ahkar-kyaw/e_me599_Zephyr/03_electrical/datasheets/Pinout_esp32_nodemcu.png

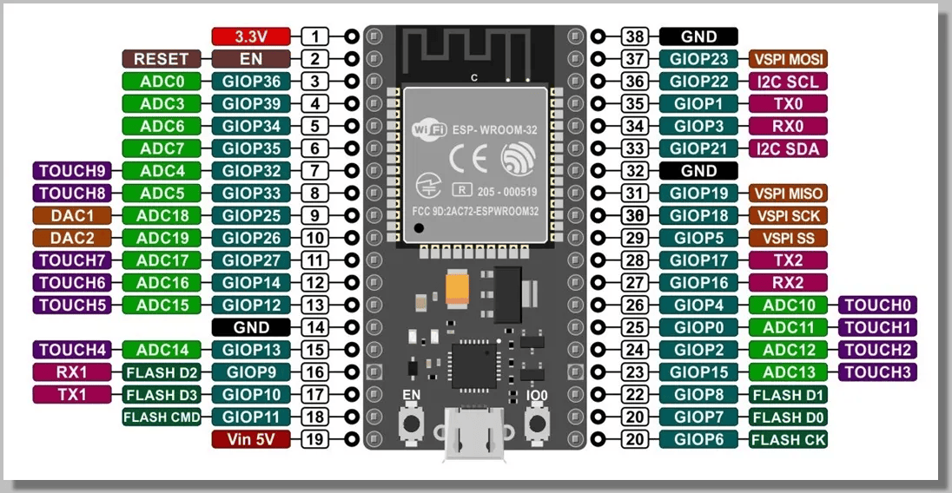
03_electrical/datasheets/Pinout_esp32_nodemcu.png
