ahkar-kyaw/e_me599_Zephyr/README.md

# Collinear mecanum drive self-balancing mobile robot
