ahkar-kyaw/e_me599_Zephyr/99_archive/documentation_actuator_CubeMars_AK40-10_KV170/AK40-10 KV170.STEP

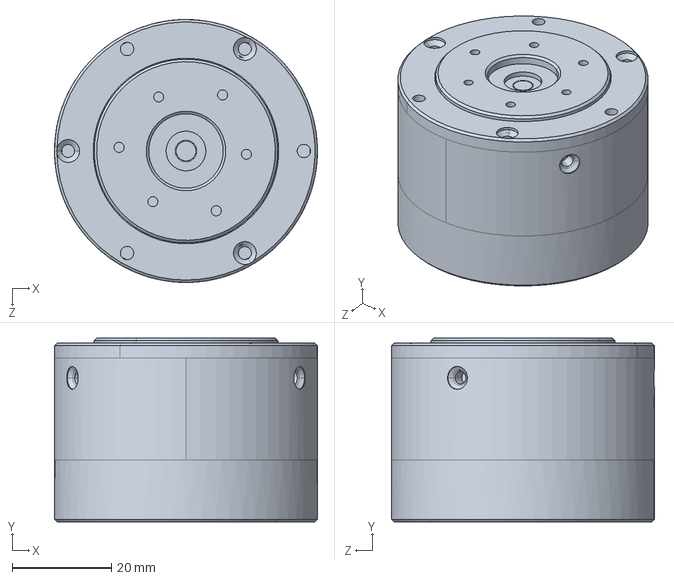
[picture p2: CAD file, 2026-05-18, an earlier design]
99_archive/documentation_actuator_CubeMars_AK40-10_KV170/AK40-10 KV170.STEP
53.0 x 37.0 x 53.0 mm
