ahkar-kyaw/e_me599_Zephyr/03_electrical/esp32_nodemcu/esp32_nodemcu.kicad_sch

## KiCad design 03_electrical/esp32_nodemcu/esp32_nodemcu.kicad_sch (2026-08-22)

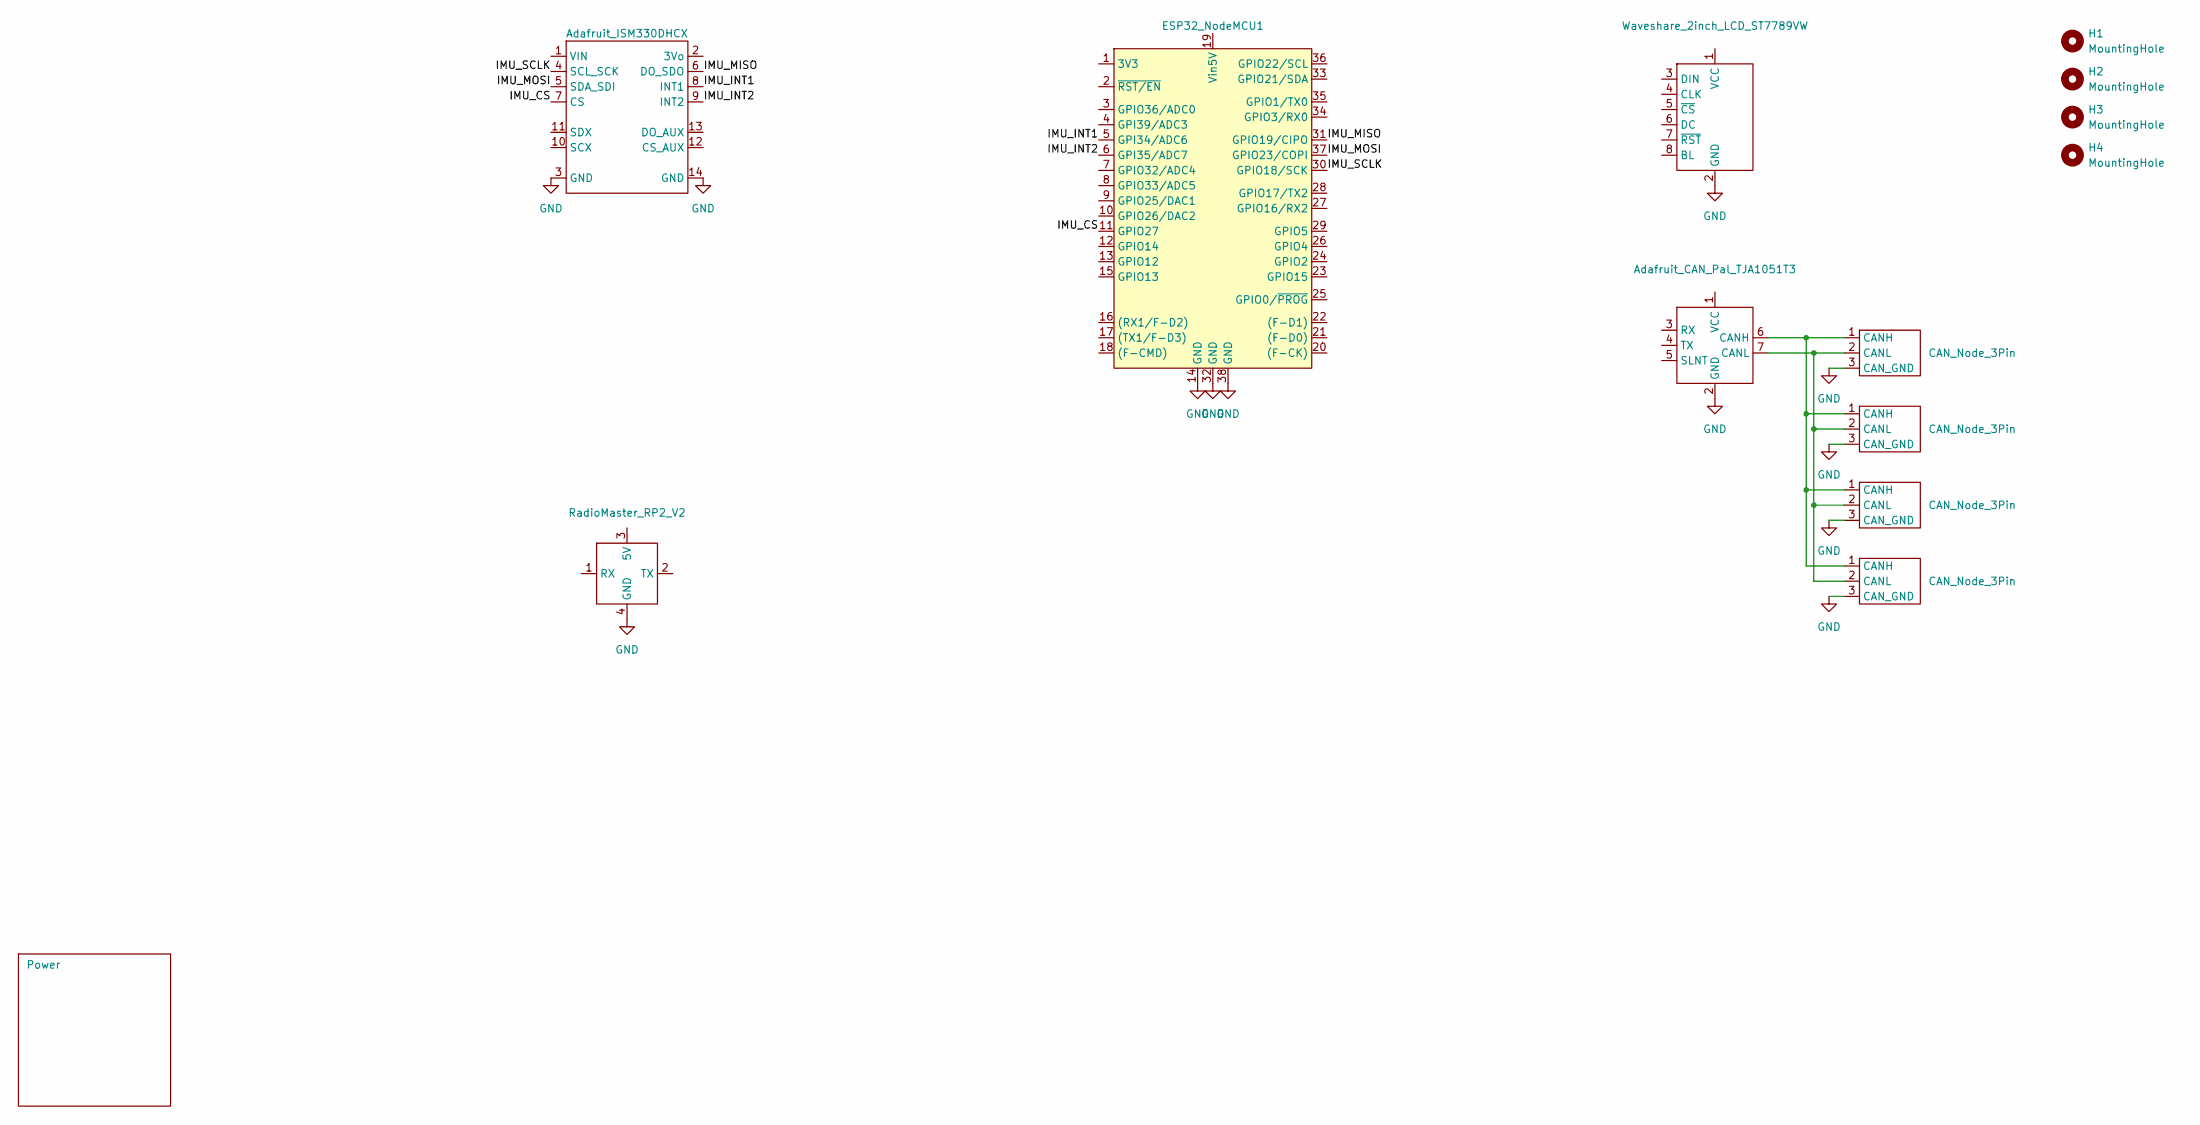
[picture p5: schematic esp32_nodemcu.kicad_sch]

Parts:
A1: Adafruit_ISM330DHCX
A2: Adafruit_CAN_Pal_TJA1051T3
A3: RadioMaster_RP2_V2
DS1: Waveshare_2inch_LCD_ST7789VW
H1, H2, H3, H4: MountingHole
J1, J2, J3, J4: CAN_Node_3Pin
U1: ESP32_NodeMCU1; ESP32_NodeMCU

Connections:
GND: A1.3 (GND), A1.14 (GND), A2.2 (GND), A3.4 (GND), DS1.2 (GND), J1.3 (CAN_GND), J2.3 (CAN_GND), J3.3 (CAN_GND), J4.3 (CAN_GND), U1.14 (GND), U1.32 (GND), U1.38 (GND)
IMU_CS: A1.7 (CS), U1.11 (GPIO27)
IMU_INT1: A1.8 (INT1), U1.5 (GPI34/ADC6)
IMU_INT2: A1.9 (INT2), U1.6 (GPI35/ADC7)
IMU_MISO: A1.6 (DO_SDO), U1.31 (GPIO19/CIPO)
IMU_MOSI: A1.5 (SDA_SDI), U1.37 (GPIO23/COPI)
IMU_SCLK: A1.4 (SCL_SCK), U1.30 (GPIO18/SCK)
unnamed: A2.6 (CANH), J1.1 (CANH), J2.1 (CANH), J3.1 (CANH), J4.1 (CANH)
unnamed: A2.7 (CANL), J1.2 (CANL), J2.2 (CANL), J3.2 (CANL), J4.2 (CANL)
