ahkar-kyaw/e_me599_Zephyr/03_electrical/esp32_nodemcu/_restore_backup_2026-08-21T19-34-02-520/esp32_nodemcu.kicad_sch

## KiCad design 03_electrical/esp32_nodemcu/_restore_backup_2026-08-21T19-34-02-520/esp32_nodemcu.kicad_sch (2026-08-22)

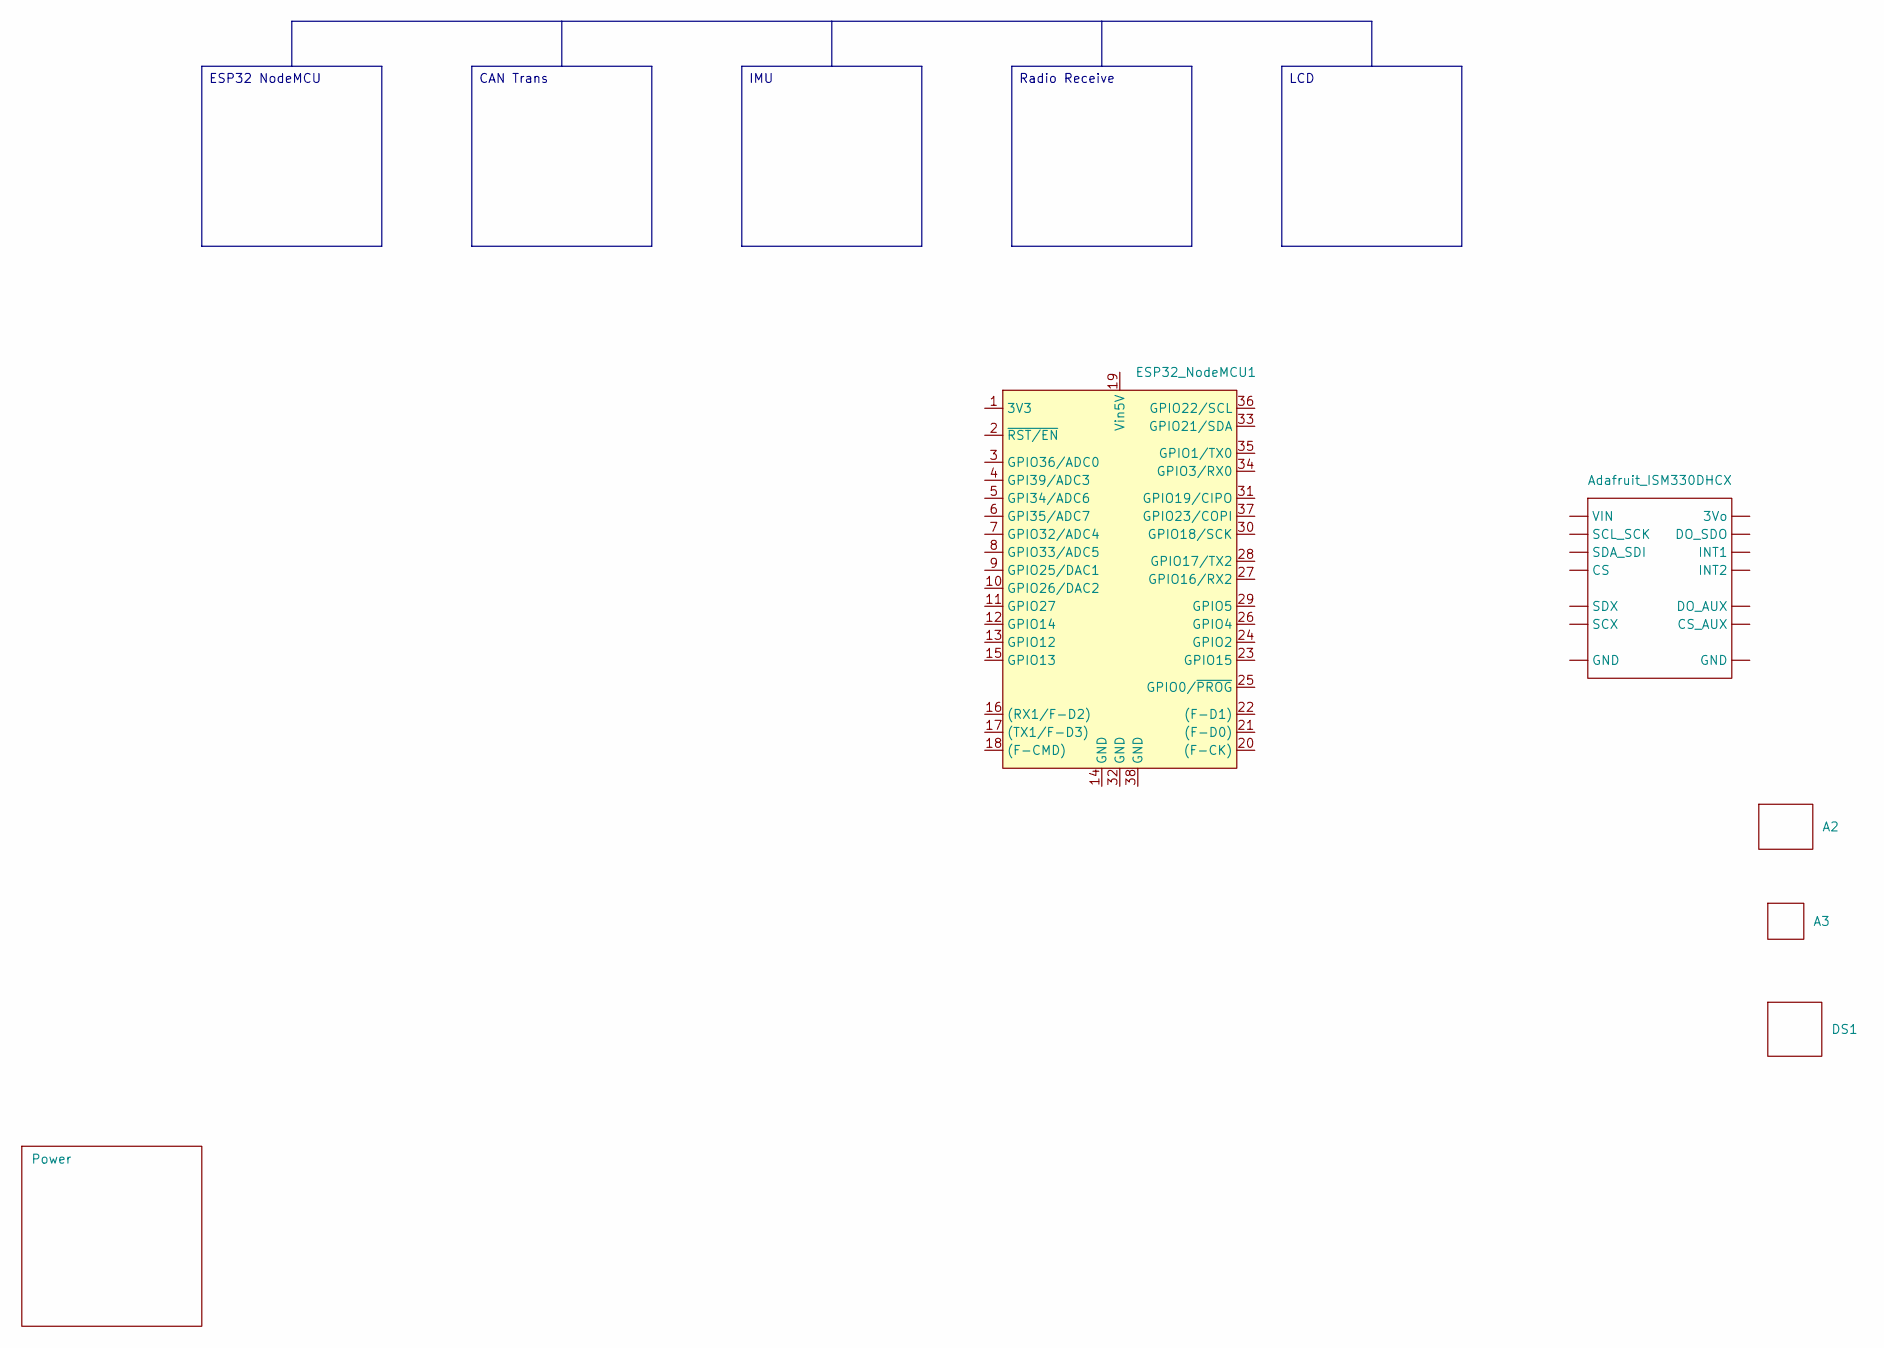
[picture p6: schematic esp32_nodemcu.kicad_sch]

Parts:
A1: Adafruit_ISM330DHCX
A2, A3: (no value)
DS1: (no value)
ESP32_NodeMCU1: ESP32_NodeMCU

Notes on the sheet:
Radio Receive
CAN Trans
LCD
ESP32 NodeMCU
IMU
