ahkar-kyaw/e_me599_Zephyr/04_firmware/platforms/esp32/main/main.c

#include "task_imu.h"
#include "task_motor.h"
#include "task_rc.h"
#include "task_safety.h"
#include "task_supervisor.h"
#include "task_ui.h"

#include "esp_log.h"

static const char *TAG = "app_main";

void app_main(void)
{
    ESP_LOGI(TAG, "ESP32 firmware booting");

    task_imu_start();

#if APP_ENABLE_ACTUATORS
    task_motor_start();
#endif

#if APP_ENABLE_RC_RECEIVER
    task_rc_start();
#endif

#if APP_ENABLE_UI
    task_ui_start();
#endif

#if APP_ENABLE_ACTUATORS && APP_ENABLE_RC_RECEIVER && APP_ENABLE_UI
    task_supervisor_start();
    task_safety_start();
#endif

}
