ahkar-kyaw/e_me599_Zephyr/04_firmware/platforms/stm32/Core/Inc/main.h

#define DBG_LED1_Pin GPIO_PIN_0
#define DBG_LED1_GPIO_Port GPIOB
#define DBG_LED3_Pin GPIO_PIN_14
#define DBG_LED3_GPIO_Port GPIOB
#define STLK_VCP_RX_Pin GPIO_PIN_8
#define STLK_VCP_RX_GPIO_Port GPIOD
#define STLK_VCP_TX_Pin GPIO_PIN_9
#define STLK_VCP_TX_GPIO_Port GPIOD
#define SWDIO_Pin GPIO_PIN_13
#define SWDIO_GPIO_Port GPIOA
#define SWCLK_Pin GPIO_PIN_14
#define SWCLK_GPIO_Port GPIOA
#define DBG_LED2_Pin GPIO_PIN_1
#define DBG_LED2_GPIO_Port GPIOE
