ahkar-kyaw/e_me599_Zephyr/(commit log)

2026-05-18 Add AK40-10 CubeMars docs; update .gitignore
    Add vendor documentation for the CubeMars AK40-10 (KV170) actuator under 99_archive: STEP CAD file, driver/setup executables, tool, manuals, firmware, 2D drawing and installation PDFs. Expand .gitignore with CMake, SolidWorks, KiCad and macOS entries to ignore IDE/OS and CAD/tooling artifacts. Also include small README.md updates.
    [AK40-10 KV170.STEP]
2026-05-19 Add zephyr.ioc STM32 MicroXplorer config
    Add MicroXplorer (.ioc) project configuration for the zephyr firmware targeting STM32H723ZGTx. Includes STM32CubeMX settings (MxCube v6.17.0) such as RCC/peripheral clock frequencies, NVIC priorities, ProjectManager options (CMake toolchain, heap/stack sizes, main location), MCU/package info and board=custom. This file provides the MCU and clock configuration used to generate HAL/initialization code for the Zephyr firmware.
2026-05-20 Move zephyr files to 04_firmware and add build
    Rename/move files from 04_firmware/zephyr/... into 04_firmware/... to flatten the firmware directory structure. Affected items include Core sources/headers, Drivers (CMSIS, STM32H7xx HAL), Middlewares (FreeRTOS), app code, CMake lists/presets, linker script and startup. Also add build artifacts under 04_firmware/build/Debug (build.ninja, .ninja_deps, .ninja_log, zephyr.elf, zephyr.map). This reorganizes the firmware tree and includes the generated build outputs.
2026-06-22 V1-Reset
    USART3
    FreeRTOS
    CPU - HSE - 400MHz
    testing task_debug
    [drv_ism330dhcx.c, drv_ism330dhcx.h, main.c]
2026-06-23 baseline_01_freertos_uart_hsi_400mhz
    USART3 debug UART works at 115200 using HSI PLL source.
    HSE PLL source produced UART baud mismatch or gibberish.
    HSE validation deferred to separate clock validation step.
    [Zephyr.kicad_sch]
2026-07-08 WIP - Reordering 04_firmware to work with both stm32 and esp32
2026-07-09 Need to test. But good setup point. Laid out foundation for esp32 and stm32 code work.
2026-07-09 Setpoint 1. Blink led works on both esp32 and stm32. Good file structure.
2026-07-23 IMU Test
2026-07-23 Cleanup IMU
2026-07-25 IMU Complimentary Filter implemented.
2026-07-26 IMU checkpoint
2026-07-26 Checkpoint IMU
    README included
2026-07-30 Replaced OLED from SSD1306 to SSD1351
    [board_esp32_nodemcu_v1.h, bsp_display_spi_esp32.c, bsp_display_spi_esp32.h, config_ui.h, main.c, task_ui.c]
2026-08-01 Able to move the motor from controller.
2026-08-06 Checkpoint
    Clean setup
    IMU works
    CRSF works
    LCD works
    CAN woks.
2026-08-22 WIP electrical
    [NUCLEO_H723ZG.kicad_sch, Zephyr.kicad_pcb, Zephyr.kicad_sch, esp32_nodemcu.kicad_pcb, esp32_nodemcu.kicad_sch, power.kicad_sch]
