ahkar-kyaw/e_me599_Zephyr/(notices)

Notices in the files:
04_firmware/platforms/stm32/Core/Inc/main.h:
Copyright (c) 2026 STMicroelectronics.
All rights reserved.
This software is licensed under terms that can be found in the LICENSE file
